Mental-Noise/Synapse/schematics/README.txt

For personal use only !

Commercial use is not authorized.
            
How to use：

At editor, Click the document icon on the topbar, via "Document" > "Open" > "EasyEDA Source", and select json file, then open it at the editor.
