Mental-Noise/Synapse/(list of files, drawings)

Other design files:
schematics/easyeda-schematics.json
