Mental-Noise/Synapse/(commit log)

2020-05-28 Add schematics
    [easyeda-schematics.json]
2020-05-29 Update schematics
    [easyeda-schematics.json]
2020-07-07 Update schematics to reflect production version r1.1
    [easyeda-schematics.json]
2020-07-07 Working version of the Arduino Sketch
2020-07-11 Add missing 10k pulldown resistor on analog pins A2 to A7
